cwb001/N20-luosidao/README.md

# **物料成本约在30~40的N20减速电机螺丝刀**
>[立创开源地址](https://oshwhub.com/12344321A/luo-si-dao)
>

### 需要材料：
* 1.基本的电子焊接工具
* 2.Bom表内的电子元件（微动开关记得选带柄的）和电池（18650塞不进，可以用热风枪吹软管子扩大空间）
* 3.N20减速电机及联轴器（3mm-5mm）和套筒（4mm）
* 4.砂纸（打磨n20电机外部）
* 5.内径为20mm的pvc塑料管和管帽
* 6.锯子

## 首先把pcb板焊接完成，包括电池
电池要先焊好并穿进管内将导线顺出管外焊接（导线记得长一点）
4xpO5HIC4MlFtWLpZIUyI8oPBLOHH0Nv3jUkXJ1R
## **然后将PVC管像这样开一个槽，让板子可以卡住以免在管内转动**
bAzJ0VcKBhXANRKnp7egdkhxbsTwRYxqm1FqcWTp
## **管体和管帽用烙铁烫出相应的洞和孔就可以使用啦**
### 演示视频
Watch the video (https://oshwhub.com/attachments/2022/9/dnT8eAkd1zMinv98jRwuhVxUaH4jX998EtYauB0i.mp4)
