cwb001/N20-luosidao/电动螺丝刀/BOM_N20电动螺丝刀.xlsx

ID | Name | Designator | Footprint | Quantity
1 | 10u | C1,C3 | C0603 | 2
2 | 0.1u | C2,C4 | C0603 | 2
3 | 1N5817WS | D1,D3 | SOD-323_L1.8-W1.3-LS2.5-RD | 2
4 | 电机+ | J1 | HDR-M-2.54_1X1 | 1
5 | 电机- | J2 | HDR-M-2.54_1X1 | 1
6 | HDR-M-2.54_1x1 | J3,J4 | HDR-M-2.54_1X1 | 2
7 | LED-0603_R | LED1,LED3,LED4,LED5,LED6,LED7 | LED0603_RED | 6
8 | LED-0603_G | LED2 | LED0603_GREEN | 1
9 | S8050_C2926165 | Q1,Q3 | SOT-23-3_L2.9-W1.3-P1.90-LS2.4-BR | 2
10 | 1.2k/1% | R1 | R0603 | 1
11 | 1k | R2,R5,R8 | R0603 | 3
12 | 20k | R3 | R0603 | 1
13 | 0.3R | R4 | R0603 | 1
14 | 10kΩ | R6 | RES-ADJ-SMD_3P-L3.0-W3.8-P1.75-BR | 1
15 | 30k | R7 | R0603 | 1
16 | 50R | R9 | R0603 | 1
17 | 微动开关 | SW3,SW4 | SW-TH_DEALON_LF-108 | 2
18 | TP4056 | U1 | SOP8_150MIL_JX | 1
19 | micro 5PFour-legged board7.2There is a column card point0.4m | USB | MICRO-USB-SMD_5P-P0.65-H-F-C40943 | 1
