cwb001/N20-luosidao/电动螺丝刀/PCB_螺丝刀_2022-09-17.dxf

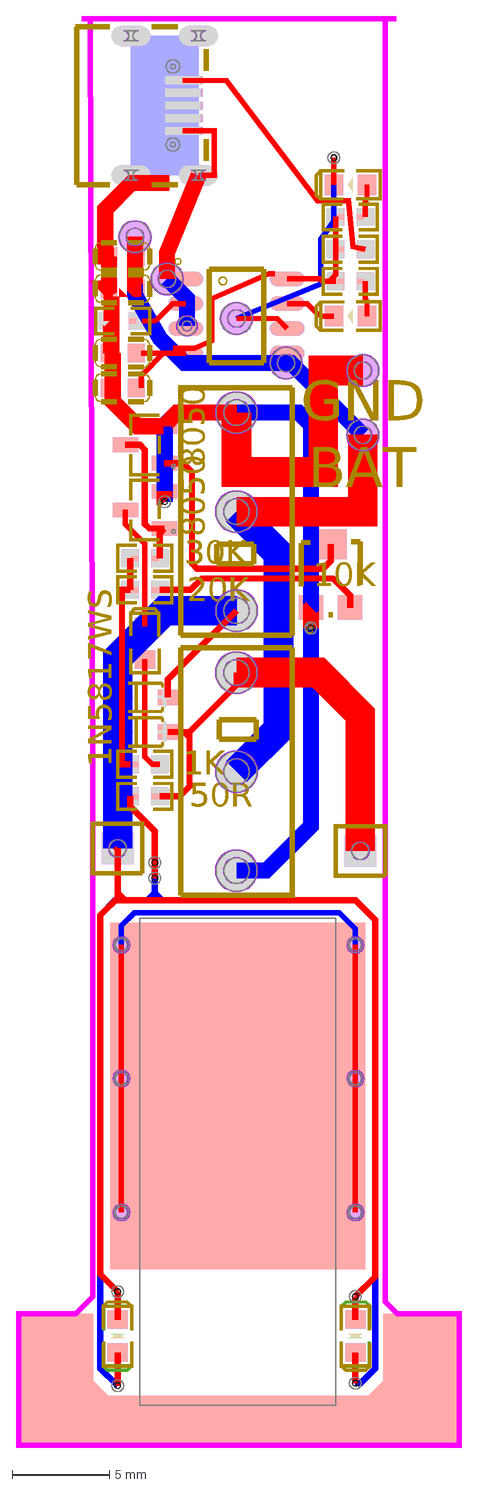
[picture p1: CAD file, 2022-09-17]
电动螺丝刀/PCB_螺丝刀_2022-09-17.dxf
30K
1K
8050
1N5817WS
20K
10K
50R
BAT
GND
