cwb001/N20-luosidao/电动螺丝刀/Schematic_N20电动螺丝刀_2022-09-17.pdf

# USB

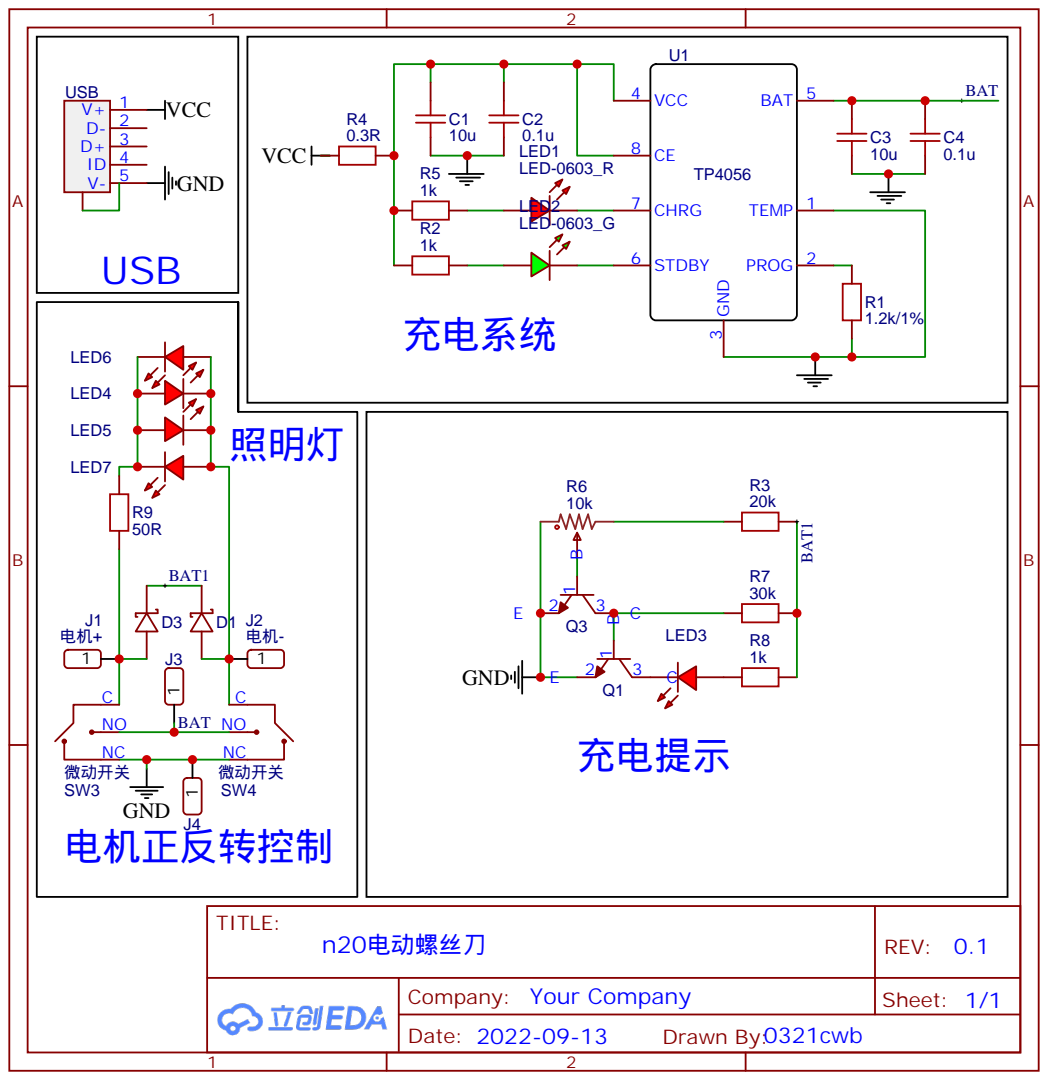
[picture p2: page 1]
