cwb001/N20-luosidao/(list of files, drawings)

Other design files:
电动螺丝刀/n20电动螺丝刀_TEST（测试用！！！）.schdoc
电动螺丝刀/PCB_PCB_螺丝刀_2022-09-17.json
电动螺丝刀/PCB_螺丝刀_TEST（测试用！！！）.pcbdoc
电动螺丝刀/SCH_N20电动螺丝刀_2022-09-17.json
